JeremyJStarcher/kim-1-clone-hardware/README.md

# kim-1-clone-hardware
Some hardware projects for the KIM-1 clone the PAL-1 and PAL-2
