JeremyJStarcher/kim-1-clone-hardware/pico-tty/pico-tty.kicad_pcb

## KiCad design pico-tty/pico-tty.kicad_pcb (2025-05-04)

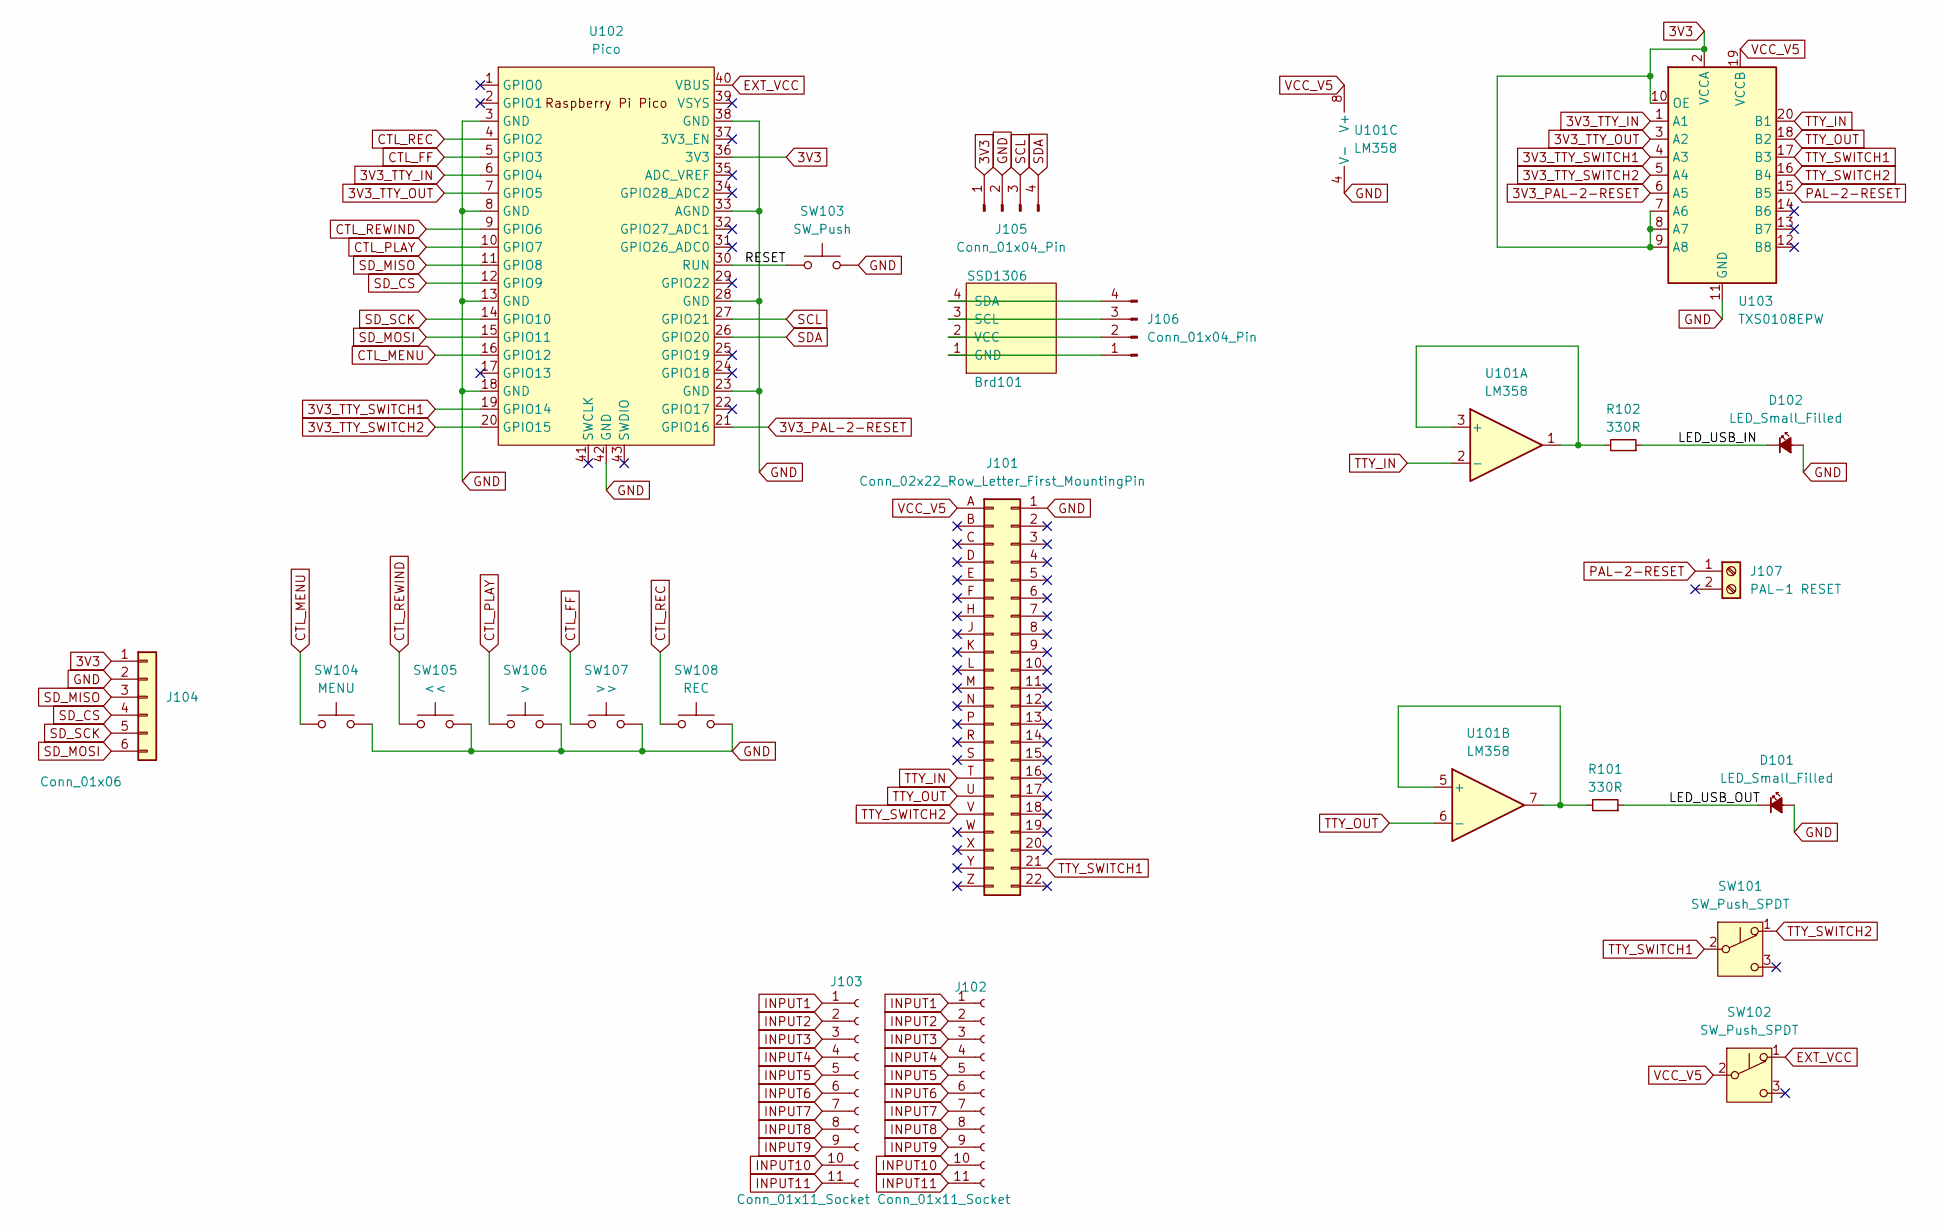
[picture p1: schematic pico-tty.kicad_sch]

Parts:
Brd101: SSD1306; 128x64OLED
D101, D102: LED_Small_Filled; LED_D5.0mm
J101: Conn_02x22_Row_Letter_First_MountingPin; IDC-Header_2x22_P2.54mm_Horizontal
J102: Conn_01x11_Socket; PinSocket_1x11_P2.54mm_Horizontal
J103: Conn_01x11_Socket; PinSocket_1x11_P2.54mm_Vertical
J104: Conn_01x06; PinSocket_1x06_P2.54mm_Vertical
J105, J106: Conn_01x04_Pin; PinHeader_1x04_P2.54mm_Vertical
J107: PAL-1 RESET; TerminalBlock_Xinya_XY308-2.54-2P_1x02_P2.54mm_Horizontal
R101, R102: 330R; R_Axial_DIN0204_L3.6mm_D1.6mm_P5.08mm_Horizontal
SW101, SW102: SW_Push_SPDT; switch
SW103: SW_Push; SW_PUSH_6mm
SW104: MENU; SW_PUSH_6mm
SW105: <<; SW_PUSH_6mm
SW106: >; SW_PUSH_6mm
SW107: >>; SW_PUSH_6mm
SW108: REC; SW_PUSH_6mm
U101: LM358; DIP-8_W7.62mm_LongPads
U102: Pico; RPi_PicoW_SMD_TH
U103: TXS0108EPW; TSSOP-20_4.4x6.5mm_P0.65mm; LCSC Part #' TXS0108EPW

Connections:
3V3: J104.1, J105.1, U102.36 (3V3), U103.2 (VCCA), U103.7 (A6), U103.8 (A7), U103.9 (A8), U103.10 (OE)
3V3_PAL-2-RESET: U102.21 (GPIO16), U103.6 (A5)
3V3_TTY_IN: U102.6 (GPIO4), U103.1 (A1)
3V3_TTY_OUT: U102.7 (GPIO5), U103.3 (A2)
3V3_TTY_SWITCH1: U102.19 (GPIO14), U103.4 (A3)
3V3_TTY_SWITCH2: U102.20 (GPIO15), U103.5 (A4)
/LED_USB_IN: D102.1 (K), R102.1
/LED_USB_OUT: D101.1 (K), R101.1
/RESET: SW103.1, U102.30 (RUN)
CTL_FF: SW107.1, U102.5 (GPIO3)
CTL_MENU: SW104.1, U102.16 (GPIO12)
CTL_PLAY: SW106.1, U102.10 (GPIO7)
CTL_REC: SW108.1, U102.4 (GPIO2)
CTL_REWIND: SW105.1, U102.9 (GPIO6)
EXT_VCC: SW102.1 (A), U102.40 (VBUS)
GND: D101.2 (A), D102.2 (A), J101.1 (Pin_b1), J104.2, J105.2, SW103.2, SW104.2, SW105.2, SW106.2, SW107.2, SW108.2, U101.4 (V-), U102.3 (GND), U102.8 (GND), U102.13 (GND), U102.18 (GND), U102.23 (GND), U102.28 (GND), U102.33 (AGND), U102.38 (GND), U102.42 (GND), U103.11 (GND)
INPUT1: J102.1, J103.1
INPUT2: J102.2, J103.2
INPUT3: J102.3, J103.3
INPUT4: J102.4, J103.4
INPUT5: J102.5, J103.5
INPUT6: J102.6, J103.6
INPUT7: J102.7, J103.7
INPUT8: J102.8, J103.8
INPUT9: J102.9, J103.9
INPUT10: J102.10, J103.10
INPUT11: J102.11, J103.11
unnamed: Brd101.1 (GND), J106.1
unnamed: Brd101.3 (SCL), J106.3
unnamed: Brd101.4 (SDA), J106.4
unnamed: Brd101.2 (VCC), J106.2
unnamed: R102.2, U101.1, U101.3 (+)
unnamed: R101.2, U101.5 (+), U101.7
PAL-2-RESET: J107.1, U103.15 (B5)
SCL: J105.3, U102.27 (GPIO21)
SDA: J105.4, U102.26 (GPIO20)
SD_CS: J104.4, U102.12 (GPIO9)
SD_MISO: J104.3, U102.11 (GPIO8)
SD_MOSI: J104.6, U102.15 (GPIO11)
SD_SCK: J104.5, U102.14 (GPIO10)
TTY_IN: J101.T (Pin_a16), U101.2 (-), U103.20 (B1)
TTY_OUT: J101.U (Pin_a17), U101.6 (-), U103.18 (B2)
TTY_SWITCH1: J101.21 (Pin_b21), SW101.2 (B), U103.17 (B3)
TTY_SWITCH2: J101.V (Pin_a18), SW101.1 (A), U103.16 (B4)
VCC_V5: J101.A (Pin_a1), SW102.2 (B), U101.8 (V+), U103.19 (VCCB)

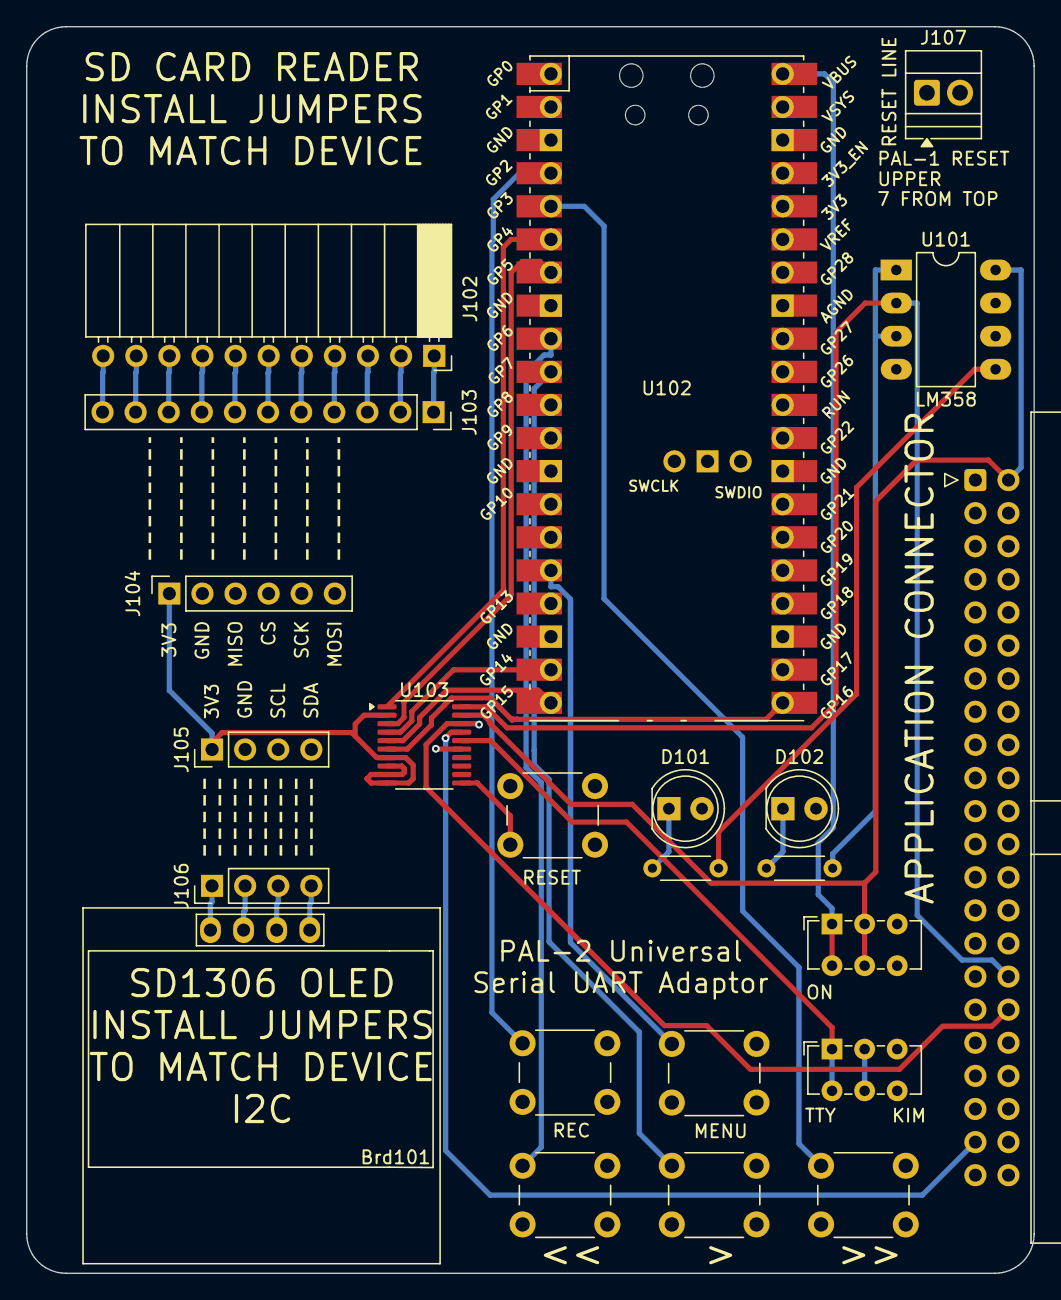
[picture p2: board pico-tty.kicad_pcb from above]

Board: 4 copper layers, 77.3 x 95.7 mm, 23 parts (0 on the bottom side), 45 nets.
