JeremyJStarcher/kim-1-clone-hardware/pal2-pico-tty/src/pal2-pico-tty.c

#include <stdio.h>
#include "pico/stdlib.h"
#include "hardware/spi.h"
#include "hardware/i2c.h"
#include "hardware/pio.h"
#include "pico/cyw43_arch.h"
#include "hardware/uart.h"
#include "pico/binary_info.h"
#include "malloc.h"
#include "pico/multicore.h"
#include "pico/cyw43_arch.h"
#include "hardware/watchdog.h"

#include "sd-card.h"
#include "proj_hw.h"
#include "buttons.h"
#include "blink.pio.h"
#include "ssd1306.h"
#include "proj_hw.h"
#include "pal-io.h"

#include "ring.h"
#include "config.h"
#include "debug.h"

#ifdef USE_BLUETOOTH
#include "bt_main.h"
#include "btstack.h"
#endif

#ifdef USE_TELNET

#include "lwip/netif.h"
#include "lwip/ip4_addr.h"
#include <pico_telnetd.h>

#include "pico/time.h"
#include "pico/cyw43_arch.h"
#include "lwip/netif.h"
#include "lwip/ip4_addr.h"

#define WIFI_RETRY_MS 100
#define WIFI_TIMEOUT_US (1000 * 1000)

// Convert wifi_connection_type_t to cyw43 auth mode
static uint32_t get_cyw43_auth_mode(wifi_connection_type_t type)
{
    switch (type)
    {
    case WIFI_CONNECTION_TYPE_WPA2:
        return CYW43_AUTH_WPA2_AES_PSK;
    case WIFI_CONNECTION_TYPE_WPA3:
        return CYW43_AUTH_WPA3_SAE_AES_PSK;
    case WIFI_CONNECTION_TYPE_OPEN:
        return CYW43_AUTH_OPEN;
    case WIFI_CONNECTION_TYPE_WEP:
        return CYW43_AUTH_OPEN; // CYW43 does not support WEP, so we treat it as open
    default:
        return CYW43_AUTH_WPA2_AES_PSK;
    }
}

static bool connect_wifi_callback(void)
{
    bool wifi_up = cyw43_tcpip_link_status(&cyw43_state, CYW43_ITF_STA) == CYW43_LINK_UP;
    static bool was_connected = false;
    static int current_ap_index = 0;

    if (wifi_up)
    {
        was_connected = true;
        return true;
    }

    int status = cyw43_tcpip_link_status(&cyw43_state, CYW43_ITF_STA);
    if (status == CYW43_LINK_JOIN)
    {
        u_printf("WIFI: Stuck joining, forcing leave...\n");
        cyw43_wifi_leave(&cyw43_state, CYW43_ITF_STA);
        sleep_ms(2000);
        watchdog_reboot(0, 0, 0);
        while (1)
        {
            tight_loop_contents();
        }
        return false;
    }

    // Only force leave if we were connected or joining
    if (was_connected && (status == CYW43_LINK_UP || status == CYW43_LINK_JOIN))
    {
        u_printf("WIFI: Forcing disconnect to reset state...\n");
        cyw43_wifi_leave(&cyw43_state, CYW43_ITF_STA);
        sleep_ms(2000);
        was_connected = false;
    }

    cyw43_arch_enable_sta_mode();

    // Try each configured WiFi access point
    for (int attempts = 0; attempts < user_config.active_wifi_count && attempts < MAX_WIFI_APS; attempts++)
    {
        int ap_index = (current_ap_index + attempts) % user_config.active_wifi_count;
        wifi_ap_config_t *ap = &user_config.wifi_aps[ap_index];

        // Skip disabled or empty access points
        if (!ap->enabled || ap->ssid[0] == '\0')
        {
            continue;
        }

        u_printf("WIFI: attempting connect to '%s'...\n", ap->ssid);

        uint32_t auth_mode = get_cyw43_auth_mode(ap->connection_type);

        int err = cyw43_arch_wifi_connect_timeout_ms(
            ap->ssid,
            ap->password,
            auth_mode,
            WIFI_TIMEOUT_US);

        if (err == 0)
        {
            u_printf("WIFI: connected to '%s'!\n", ap->ssid);
            current_ap_index = ap_index; // Remember successful AP for next time

            struct netif *netif = netif_default;
            u_printf("SSID: %s\n", ap->ssid);
            u_printf("IP:   %s\n", ip4addr_ntoa(netif_ip4_addr(netif)));
            u_printf("GW:   %s\n", ip4addr_ntoa(netif_ip4_gw(netif)));
            u_printf("MASK: %s\n", ip4addr_ntoa(netif_ip4_netmask(netif)));
            u_printf("MAC:  %02x:%02x:%02x:%02x:%02x:%02x\n",
                     netif->hwaddr[0], netif->hwaddr[1], netif->hwaddr[2],
                     netif->hwaddr[3], netif->hwaddr[4], netif->hwaddr[5]);

            // Check for a valid IP
            const char *ip = ip4addr_ntoa(netif_ip4_addr(netif));
            if (ip && strcmp(ip, "0.0.0.0") == 0)
            {
                u_printf("WIFI: got 0.0.0.0 IP, trying next AP...\n");
                continue;
            }

            // Disable power saving
            uint32_t no_pm = cyw43_pm_value(CYW43_NO_POWERSAVE_MODE, 0, 0, 0, 0);
            cyw43_wifi_pm(&cyw43_state, no_pm);

            was_connected = true;
            return true;
        }
        else
        {
            u_printf("WIFI: connect to '%s' failed (%d), trying next AP...\n", ap->ssid, err);
        }
    }

    // If we get here, all APs failed
    u_printf("WIFI: all configured access points failed, retrying...\n");
    current_ap_index = (current_ap_index + 1) % MAX(user_config.active_wifi_count, 1);
    sleep_ms(1000);
    return false;
}

#endif

static void ssd1306_set_status(ssd1306_t *disp, const char *s);
void main_loop(ssd1306_tty_t *tty);

void blink_pin_forever(PIO pio, uint sm, uint offset, uint pin, uint freq)
{
    blink_program_init(pio, sm, offset, pin);
    pio_sm_set_enabled(pio, sm, true);

    printf("Blinking pin %d at %d Hz\n", pin, freq);

    // PIO counter program takes 3 more cycles in total than we pass as
    // input (wait for n + 1; mov; jmp)
    pio->txf[sm] = (125000000 / (2 * freq)) - 3;
}

bool wait_for_usb_connection(uint timeout_ms)
{
    const absolute_time_t deadline = make_timeout_time_ms(timeout_ms);

    while (!stdio_usb_connected())
    {
        if (absolute_time_diff_us(get_absolute_time(), deadline) <= 0)
        {
            return false; // Timed out
        }
        sleep_ms(10); // Polling interval
    }
    return true; // USB connected
}

#if 0
bool repeating_timer_callback(struct repeating_timer *t)
{
    // Alright, I had to put the request on a timer to allow bytes
    // to get batched up in the ring buffer.  Otherwise, it would try
    // to send ONE CHARACTER per batch at 9600 baud, which bogged down
    // the system.
    //

    if (system_config.bt_connected_state == CONNECTION_STATE_CONNECTED)
    {
        if (!ring_is_empty(&tx_ring))
        {
            rfcomm_request_can_send_now_event(system_config.rfcomm_channel_id);
        }
    }

    return true; // Keep repeating
}
#endif

void core1_main(void)
{
    struct repeating_timer timer;
    // add_repeating_timer_ms(100, repeating_timer_callback, NULL, &timer);

    pal_io_init();

    // jjz -> configure_hardware();

    // SPI initialisation. This example will use SPI at 1MHz.
    spi_init(SPI_PORT, 1000 * 1000);
    gpio_set_function(PIN_MISO, GPIO_FUNC_SPI);
    gpio_set_function(PIN_CS, GPIO_FUNC_SIO);
    gpio_set_function(PIN_SCK, GPIO_FUNC_SPI);
    gpio_set_function(PIN_MOSI, GPIO_FUNC_SPI);

    // Chip select is active-low, so we'll initialise it to a driven-high state
    gpio_set_dir(PIN_CS, GPIO_OUT);
    gpio_put(PIN_CS, 1);
    // For more examples of SPI use see https://github.com/raspberrypi/pico-examples/tree/master/spi

    // I2C Initialisation. Using it at 400Khz.
    i2c_init(I2C_PORT, 400 * 1000);

    gpio_set_function(I2C_SDA, GPIO_FUNC_I2C);
    gpio_set_function(I2C_SCL, GPIO_FUNC_I2C);
    gpio_pull_up(I2C_SDA); // Set up our UART
    uart_init(PAL_UART, BAUD_RATE);
    // Set the TX and RX pins by using the function select on the GPIO
    // Set datasheet for more information on function select
    gpio_set_function(PAL_UART_TX_GPIO, GPIO_FUNC_UART);
    gpio_set_function(PAL_UART_RX_GPIO, GPIO_FUNC_UART);

    // Use some the various UART functions to send out data
    // In a default system, printf will also output via the default UART

    // Send out a string, with CR/LF conversions
    uart_puts(PAL_UART, " Hello, UART!\n");

    // For more examples of UART use see https://github.com/raspberrypi/pico-examples/tree/master/uart

    debug_printf("Scanning I²C\r\n");
    int i2c_addr = scan_i2c_bus();

    if (i2c_addr >= 0)
    {
        debug_printf("First I²C device @ 0x%02X\r\n", i2c_addr);
    }
    else
    {
        debug_printf("No I²C devices detected\r\n");
    }

    ssd1306_t disp;
    ssd1306_tty_t tty;

    init_ssd1306(i2c_addr, &disp);
    ssd1306_init_tty(&disp, &tty, get_font());

    ssd1306_set_status(&disp, "SCANNING DRIVE");
    debug_printf("Scanning drive\r\n");
    int k = prep_sd_card();
    debug_printf("Done scanning drive\r\n");
    ssd1306_set_status(&disp, "SCAN COMPLETE");

    load_config_from_sd();
    save_config_to_sd();

    /* --- UART setup ------------------------------------------------------ */
    uart_init(PAL_UART, user_config.baud);
    gpio_set_function(PAL_UART_TX_GPIO, GPIO_FUNC_UART);
    gpio_set_function(PAL_UART_RX_GPIO, GPIO_FUNC_UART);

    ssd1306_set_status(&disp, "SCANNING RAM");
    size_t mem_size1 = get_largest_alloc_block_binary2(1, 1024 * 1024);
    size_t freeK = (size_t)(mem_size1 / 1024);

    debug_printf("(binary) Largest chunk of free heap = %d %d\r\n", mem_size1, freeK);

    int y = 0;
    int ss = 1;
    ssd1306_clear(&disp);
    ssd1306_printf(&disp, 0, y, ss, "FREE RAM:");
    ssd1306_printf(&disp, 0, y + (8 * ss * 1), ss, "%dK", freeK);
    ssd1306_printf(&disp, 0, y + (8 * ss * 2), ss, "%d\r\n", mem_size1);
    ssd1306_show(&disp);

    init_buttons();

    gpio_pull_up(I2C_SCL);
    // For more examples of I2C use see https://github.com/raspberrypi/pico-examples/tree/master/i2c

    main_loop(&tty);
}

#ifdef USE_TELNET

static int scan_result(void *env, const cyw43_ev_scan_result_t *result)
{
    if (result)
    {
        printf("ssid: %-32s rssi: %4d chan: %3d mac: %02x:%02x:%02x:%02x:%02x:%02x sec: %u\n",
               result->ssid, result->rssi, result->channel,
               result->bssid[0], result->bssid[1], result->bssid[2], result->bssid[3], result->bssid[4], result->bssid[5],
               result->auth_mode);
    }
    return 0;
}

void wifi_scan()
{
    cyw43_arch_enable_sta_mode();

    absolute_time_t scan_time = nil_time;
    bool scan_in_progress = false;
    while (true)
    {
        if (absolute_time_diff_us(get_absolute_time(), scan_time) < 0)
        {
            if (!scan_in_progress)
            {
                cyw43_wifi_scan_options_t scan_options = {0};
                int err = cyw43_wifi_scan(&cyw43_state, &scan_options, NULL, scan_result);
                if (err == 0)
                {
                    printf("\nPerforming wifi scan\n");
                    scan_in_progress = true;
                }
                else
                {
                    printf("Failed to start scan: %d\n", err);
                    scan_time = make_timeout_time_ms(10000); // wait 10s and scan again
                }
            }
            else if (!cyw43_wifi_scan_active(&cyw43_state))
            {
                scan_time = make_timeout_time_ms(10000); // wait 10s and scan again
                scan_in_progress = false;
            }
        }
        // the following #ifdef is only here so this same example can be used in multiple modes;
        // you do not need it in your code
#if PICO_CYW43_ARCH_POLL
        // if you are using pico_cyw43_arch_poll, then you must poll periodically from your
        // main loop (not from a timer) to check for Wi-Fi driver or lwIP work that needs to be done.
        cyw43_arch_poll();
        // you can poll as often as you like, however if you have nothing else to do you can
        // choose to sleep until either a specified time, or cyw43_arch_poll() has work to do:
        cyw43_arch_wait_for_work_until(scan_time);
#else
        // if you are not using pico_cyw43_arch_poll, then WiFI driver and lwIP work
        // is done via interrupt in the background. This sleep is just an example of some (blocking)
        // work you might be doing.
        sleep_ms(1000);
#endif
    }
}

#endif

int main()
{
    stdio_init_all();

    bt_ring_init(&bt_tx_ring);
    bt_ring_init(&bt_rx_ring);

    bool connected = wait_for_usb_connection(1000);

#ifndef USE_TELNET
    // Initialise the Wi-Fi chip
    if (cyw43_arch_init())
    {
        printf("cyw43_arch_init() failed.\n");
        return -1;
    }

#endif

#ifdef USE_TELNET
    void start_telnet()
    {
        system_config.telnetserver = telnet_server_init(1024, 1024); // input and output buffer sizes
        if (!system_config.telnetserver)
        {
            panic("out of memory");
        }

        system_config.telnetserver->mode = TELNET_MODE;
        telnet_server_start(system_config.telnetserver, true); // Disable STDIO -- does wierd werid things to the serial console */

        printf("TELNET SERVER STARTED\n");
    }
#endif

#ifdef USE_TELNET

    if (cyw43_arch_init_with_country(CYW43_COUNTRY_USA))
    {
        u_printf("WIFI: init failed\n");
        return -1;
    }

    // Only try to connect if we have configured access points
    if (user_config.active_wifi_count > 0)
    {
        while (true)
        {
            bool is_connected = connect_wifi_callback();
            if (is_connected)
            {
                break;
            }
        }
    }
    else
    {
        u_printf("WIFI: No access points configured, skipping WiFi connection\n");
    }

    // // Somewhere in your init (e.g. after stdio_init_all()):
    // struct repeating_timer wifi_timer;
    // add_repeating_timer_ms(
    //     WIFI_RETRY_MS,         // retry every 100 ms
    //     connect_wifi_callback, // your callback
    //     NULL,                  // no user data
    //     &wifi_timer);
#endif

    // Example to turn on the Pico W LED
    cyw43_arch_gpio_put(CYW43_WL_GPIO_LED_PIN, 1);

    multicore_launch_core1(core1_main); // 1️⃣ start core-1 and its IO

#ifdef USE_BLUETOOTH
    bt_main();
#endif

    while (true)
    {
#ifdef USE_TELNET
        static bool telnet_started = false;
        bool is_connected = connect_wifi_callback();
        if (is_connected)
        {
            // u_printf("WIFI: connected successfully\n");
            if (!telnet_started)
            {
                start_telnet();
                telnet_started = true;
            }
        }
        else
        {
            u_printf("WIFI: still trying to connect...\n");
        }
#endif
        sleep_ms(1 * 1000);
    }
}

static void ssd1306_set_status(ssd1306_t *disp, const char *s)
{
    ssd1306_clear(disp);
    ssd1306_draw_string(disp, 0, 24, 1, s);
    ssd1306_show(disp);
}

void show_default_text(ssd1306_tty_t *tty)
{

    char bt_mesg[] = "BT";
    char usb_mesg[] = "USB";

    ssd1306_tty_set_scale(tty, user_config.menu_scale);
    //  ssd1306_tty_set_scale(tty, 1);

    ssd1306_tty_cls(tty);
    //  ssd1306_tty_puts(tty, "USB<->PAL2\n");
    if (system_config.tty_mode)
    {
        ssd1306_tty_puts(tty, "TTY MODE\n");
    }
    else
    {
        ssd1306_tty_puts(tty, "PAL2 MODE\n");
    }

    ssd1306_tty_printf(tty, "%c TOGGLE.\n", user_config.toggle_char);

#if 1
    for (size_t i = 0; i < strlen(bt_mesg); i++)
    {

        tty->current_color = system_config.bt_connected_state == CONNECTION_STATE_CONNECTED
                                 ? SSD1306_COLOR_INVERSE
                                 : SSD1306_COLOR_NORMAL;

        ssd1306_tty_putchar(tty,
                            system_config.bt_connected_state == CONNECTION_STATE_CONNECTED
                                ? bt_mesg[i]
                                : ' ');
    }
    tty->current_color = SSD1306_COLOR_NORMAL;
#endif

#if 1
    if (system_config.file_status == FILE_STATUS_GOOD)
    {
        ssd1306_tty_puts(tty, " OK  ");
    }
    else if (system_config.file_status == FILE_STATUS_ERROR)
    {
        ssd1306_tty_puts(tty, " ERR ");
    }
    else
    {
        ssd1306_tty_puts(tty, " --- ");
    }
#endif

#if 1
    for (size_t i = 0; i < strlen(usb_mesg); i++)
    {
        tty->current_color = system_config.usb_connected_state == CONNECTION_STATE_CONNECTED
                                 ? SSD1306_COLOR_INVERSE
                                 : SSD1306_COLOR_NORMAL;

        ssd1306_tty_putchar(tty,
                            system_config.usb_connected_state == CONNECTION_STATE_CONNECTED
                                ? usb_mesg[i]
                                : ' ');
    }
#endif

    tty->current_color = SSD1306_COLOR_NORMAL;

    ssd1306_tty_show(tty);
}

void check_connections(ssd1306_tty_t *tty)
{
    bool has_changed = false;

    if (system_config.bt_connected_state == CONNECTION_STATE_NEW_CONNECTION)
    {
        u_banner("BLUETOOTH CONNECTION ESTABLISHED");
        system_config.bt_connected_state = CONNECTION_STATE_CONNECTED;
        has_changed = true;
    }

    if (system_config.bt_connected_state == CONNECTION_STATE_NEW_DISCONNECT)
    {
        u_banner("BLUETOOTH CONNECTION LOST");
        system_config.bt_connected_state = CONNECTION_STATE_NOT_CONNECTED;
        has_changed = true;
    }

    if (stdio_usb_connected() && system_config.usb_connected_state == CONNECTION_STATE_NOT_CONNECTED)
    {
        u_banner("USB CONNECTION ESTABLISHED");
        system_config.usb_connected_state = CONNECTION_STATE_CONNECTED;
        has_changed = true;
    }

    if (!stdio_usb_connected() && system_config.usb_connected_state != CONNECTION_STATE_NOT_CONNECTED)
    {

        u_banner("USB CONNECTION LOST");
        system_config.usb_connected_state = CONNECTION_STATE_NOT_CONNECTED;
        has_changed = true;
    }

#if USE_TELNET
    bool wifi_up = cyw43_tcpip_link_status(&cyw43_state, CYW43_ITF_STA) == CYW43_LINK_UP;
    if (wifi_up && system_config.wifi_connected_state != CONNECTION_STATE_CONNECTED)
    {
        u_banner("WIFI CONNECTED");
        system_config.wifi_connected_state = CONNECTION_STATE_CONNECTED;
        has_changed = true;
    }
    else if (!wifi_up && system_config.wifi_connected_state == CONNECTION_STATE_CONNECTED)
    {
        u_banner("WIFI DROPPED");
        system_config.wifi_connected_state = CONNECTION_STATE_NOT_CONNECTED;
        has_changed = true;
    }
#endif

    if (has_changed)
    {
        reset_screen_timer();
        show_default_text(tty);
    }
}

void main_loop(ssd1306_tty_t *tty)
{
    reset_pal(tty);
    show_default_text(tty);
    u_reset_terminal();

    while (true)
    {
        bool idle = true;

        /* USB‑>PAL */
        int ch_user = user_getchar();

        if (ch_user > -1)
        {
            user_pressed_key_set(true);

            if ((char)ch_user == user_config.toggle_char)
            {
                u_reset_terminal();

                if (system_config.tty_mode)
                {
                    u_banner("TTY MODE DISABLED.");
                    disable_tty_mode(tty);
                }
                else
                {
                    u_banner("TTY MODE ENABLED.");
                    enable_tty_mode(tty);
                }
                show_default_text(tty);
                u_reset_terminal();
                continue;
            }

            pal_putc((uint8_t)ch_user);
            idle = false;
        }

        /* PAL‑>USB */
        int ch_pal = pal_getchar();
        if (ch_pal > -1)
        {
            u_putc(ch_pal);
            idle = false;
        }

        if (idle)
        {
            button_state_t btn = read_buttons_struct(tty);

            if (btn.menu == BUTTON_STATE_PRESSED)
            {
                ssd1306_tty_puts(tty, "MENU pressed\n");

                process_menu(tty);
                show_default_text(tty);

                // Just in case something got left in a weird state
                u_reset_terminal();
            }
            else
            {
                sleep_ms(10);
            }
        }

        check_connections(tty);
    }
}
