JeremyJStarcher/kim-1-clone-hardware/pal2-pico-tty/src/config.h

#pragma once

#ifdef __cplusplus
extern "C"
{
#endif

#include <stdbool.h>
#include <stdint.h>
#include "ring.h"

#ifdef USE_TELNET
#include <pico_telnetd.h>
#endif

    typedef enum
    {
        FILE_STATUS_NONE, /* not yet evaluated / no file          */
        FILE_STATUS_GOOD, /* file present and OK                  */
        FILE_STATUS_ERROR /* any error condition                  */
    } file_status_t;

    typedef enum
    {
        CONNECTION_STATE_NOT_CONNECTED = 10,
        CONNECTION_STATE_NEW_CONNECTION = 11,
        CONNECTION_STATE_CONNECTED = 12,
        CONNECTION_STATE_NEW_DISCONNECT = 13,
    } connection_state_t;

    typedef enum
    {
        WIFI_CONNECTION_TYPE_WPA2,
        WIFI_CONNECTION_TYPE_WPA3,
        WIFI_CONNECTION_TYPE_OPEN,
        WIFI_CONNECTION_TYPE_WEP
    } wifi_connection_type_t;

#define MAX_WIFI_SSID_LEN 32
#define MAX_WIFI_PASSWORD_LEN 64
#define MAX_WIFI_APS 5

    typedef struct
    {
        char ssid[MAX_WIFI_SSID_LEN + 1];
        char password[MAX_WIFI_PASSWORD_LEN + 1];
        wifi_connection_type_t connection_type;
        bool enabled;
    } wifi_ap_config_t;

    typedef struct
    {
        bool usb_connected;
        uint8_t oled_address;
        bool tty_mode;
        const char *soft_version;
        file_status_t file_status;
        uint16_t rfcomm_channel_id;
        connection_state_t bt_connected_state;
        connection_state_t usb_connected_state;
        connection_state_t wifi_connected_state;

#ifdef USE_TELNET
        tcp_server_t *telnetserver;
#endif

    } pal_config_t;

    extern pal_config_t system_config;

    typedef struct
    {
        uint16_t baud;
        uint16_t ch_delay;
        uint16_t line_delay;

        bool use_hard_reset;
        char toggle_char;
        bool force_upper_case;
        bool bs_to_del;
        uint16_t oled_brightness;
        uint16_t menu_scale; // Scale for menu items, e.g., 1 for normal, 2 for double size

        wifi_ap_config_t wifi_aps[MAX_WIFI_APS];
        uint16_t active_wifi_count;
    } user_config_t;

    // Types of config entries
    typedef enum
    {
        CT_UINT16,
        CT_BOOL,
        CT_CHAR,
        CT_STRING,
        CT_WIFI_TYPE
    } config_type_t;

    typedef enum
    {
        MENU_TYPE_NONE,
        MENU_TYPE_LIST,
    } config_menu_type_t;

    // Mapping from key name to storage location
    typedef struct
    {
        const char *key;
        config_type_t type;
        config_menu_type_t menu_type;
        void *dest;
        const char *comment;
        const char *validations;
    } config_entry_t;

    extern user_config_t user_config;
    extern config_entry_t cfg_map[];
    extern size_t cfg_map_len;

    extern volatile bt_ring_t bt_tx_ring; /* producer: core-1, consumer: core-0 */
    extern volatile bt_ring_t bt_rx_ring; /* producer: core-0, consumer: core-1 */

    bool load_config_from_sd(void);
    bool save_config_to_sd(void);
    void parse_config_line(char *line);

#ifdef __cplusplus
}
#endif
