JeremyJStarcher/kim-1-clone-hardware/(commit log)

2025-04-21 Cleaned up code, got pico/pico_w detection working.
2025-04-23 Pulled out a bunch of pico/pico-w specific code into its own file
2025-04-23 Enabled USB/UART passthrough
2025-04-24 Pin passthrough functioning correctly.
    [proj_hw.h, tty_switch_passthrough.c]
2025-05-03 Added frame buffer, but does not update screen yet.
2025-05-03 Frame buffer sent to ssd1306
2025-05-04 Renamed jjs_init to switch_passthrough_init
2025-05-04 Moved the PCB over and button read code is now working.
    [pico-tty.kicad_pcb, pico-tty.kicad_sch]
2025-05-14 Some cleanup and fixed the some of th I/O that got broken.
    Due to some refactoring without all hardware present to test
    the reset and TTY communication code stopped function.
    [buttons.c, buttons.h, debug.h, proj_hw.c, proj_hw.h, tty_switch_passthrough.c]
2025-05-15 KIM/TTY toggle added. Reset still crude
    [pal-io.c, pal-io.h, proj_hw.h]
2025-05-15 Added config settings and started switching over to them.
2025-05-15 Switched over to system_config.tty_mode
2025-05-16 Crude bluetooth serial port enabled. Just chances ASCII case.
2025-05-17 uart bridge moved to core1. bt_stack requires core0
2025-05-17 PAL2 -> Sends to bluetooth receiver.
    The code gets a bit messy but I'm not sure how much that can be helped.
    Does not receive from bluetooth device yet but I don't expect that to be hard.
2025-05-18 Resolved bluetooth lockups by putting request-to-send on an interrupt to force batching.
    [config.c, config.h, pal-io.c, ring.h]
2025-05-19 Added a dimmer and then poweroff when keyboard idle.
2025-05-19 USB UART connected state tracked.
2025-05-21 Resolved issue of BASIC uploads rebooting PAL.
    [buttons.c]
2025-05-21 Have the SETTINGS menu appearing correctly.
    [buttons.c, buttons.h, config.c, config.h, edit-settings.c]
2025-05-22 Switched to using the BT events instead of an outside interrupt.
2025-05-27 Fixed error that broke build. Static vars have to have a constant intitial value. Who knew :)
    [buttons.c]
2025-05-28 Code should compile with the standard SDK or with the Pico extension
2025-06-04 Reverting to a known working bluetooth config
    [config.c, config.h, pal-io.c, pal2-pico-tty.c, proj_hw.c]
2025-06-05 Dealt with some minor bugs on the telnet side.
    [pal-io.c]
